apipoj/spark-stand-dual/assets/images/README.md

# Dual render images

Project-authored renders generated on 2026-10-17. The stand is Dual v04 with solid crossbars; the distributed print bundle instead includes v05 LIGHTER open crossbars, one with a logo. The images illustrate the overall arrangement rather than the exact released bar geometry.

Computer props are procedural visualization meshes created in this project, not official NVIDIA CAD. No imported device meshes, image textures, fonts or HDRIs are used. NVIDIA product identity and trademarks remain with their owners; no endorsement is implied. These images do not establish physical load or thermal performance.

Original render filenames are preserved. Restricted project terms in ../../LICENSE.md apply to the distributed images; no rights to underlying third-party trademarks or product designs are granted.

## Owner-supplied physical-build photographs

IMG_7394.jpg and IMG_7397.jpg show the printed Dual assembly photographed on 2026-10-11. The owner explicitly requested their public inclusion on 2026-10-20. These are the existing GitHub-sized JPEG copies, preserved byte-for-byte. Original HEIC files are not distributed. One photograph shows a single DGX Spark on the lower tier; neither photograph establishes two-device load or thermal performance.
