apipoj/spark-stand-dual/projects/X2D_PLA_v04_LIGHT_plate_04_pins_x8.3mf

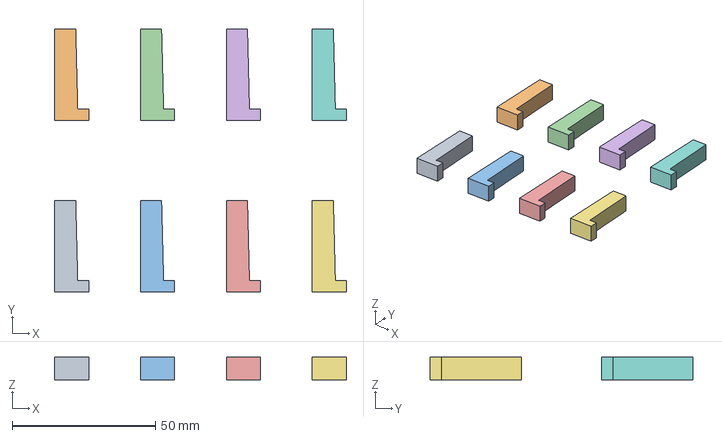
[picture p5: CAD file, 2026-10-20]
projects/X2D_PLA_v04_LIGHT_plate_04_pins_x8.3mf
102.0 x 92.0 x 8.00 mm
wedge_pin_PRINT_EIGHT x 8
