apipoj/spark-stand-dual/projects/X2D_PLA_v04_LIGHT_plate_01_right.3mf

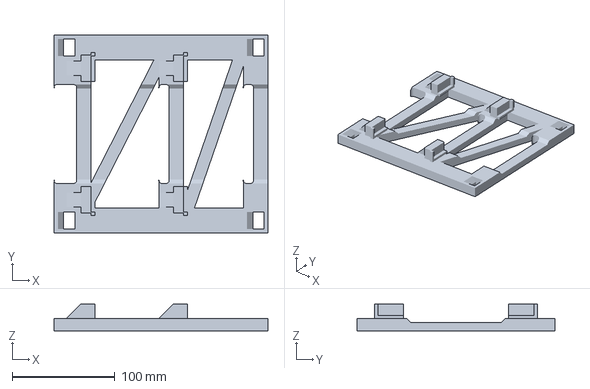
[picture p6: CAD file, 2026-10-20]
projects/X2D_PLA_v04_LIGHT_plate_01_right.3mf
208.0 x 192.0 x 26.0 mm
