apipoj/spark-stand-dual/projects/X2D_PLA_v05_LIGHTER_plate_03_crossbars_x4.3mf

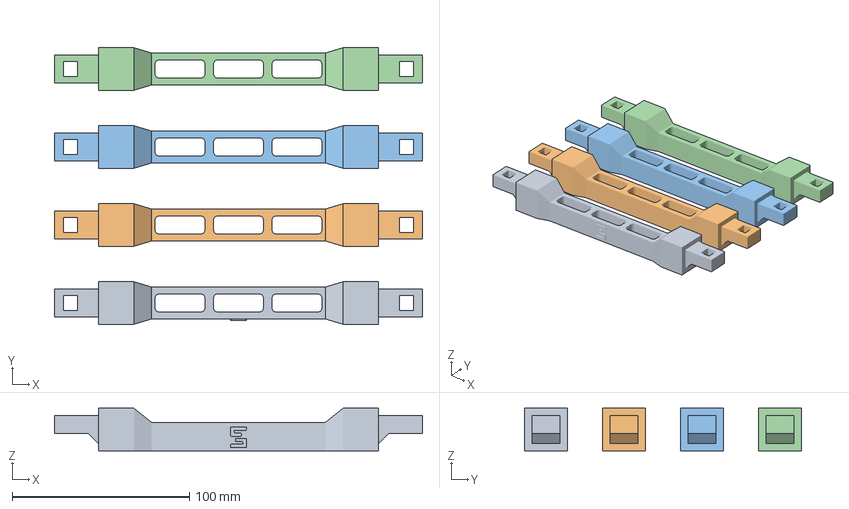
[picture p7: CAD file, 2026-10-20]
projects/X2D_PLA_v05_LIGHTER_plate_03_crossbars_x4.3mf
207.6 x 156.0 x 24.0 mm
crossbar_LOGO_PRINT_ONE
crossbar_plain x 3
