apipoj/spark-stand-dual/(list of files, cad)

Other CAD files:
projects/X2D_PLA_v04_LIGHT_plate_02_left.3mf
