apipoj/spark-stand-dual/ASSEMBLY_TH.md

# ประกอบ Spark Stand Dual

ชิ้นส่วนรวม 14 ชิ้น ได้แก่แผงซ้ายและขวา คานสี่ชิ้น และลิ่มแปดชิ้น

1. แกะ brim และ support ใต้เดือยออกให้หมด
2. ตั้งแผงสองข้างให้ชั้นรองหันเข้าใน เชื่อมด้วยคานหน้าและหลังทั้งด้านบนและด้านล่าง
3. สอดเดือยทะลุเบ้ารับจนบ่าคานแนบแผง หันด้านลาดให้ตรงกัน
4. ใส่ปลายแคบของลิ่มจากด้านบนช่องนอกแผง ด้านเรียบแนบแผง ด้านเอียงหันออก
5. กดด้วยมือให้กระชับ หัวลิ่มโผล่ได้ ไม่ตอกหรือฝืน
6. ใช้ลิ่มหนึ่งอันต่อข้อต่อ รวมแปดจุด ตรวจว่าไม่มีระยะคลอน ลิ่มไม่เลื่อนเองและปลายลิ่มไม่ยื่นต่ำกว่าฐาน

ใส่ยางรองจุดสัมผัสและใต้ฐานตามขนาดที่วัดจริง ทดลองด้วยน้ำหนักทดแทนก่อนใช้อุปกรณ์จริง หากชิ้นงานแตก แอ่น โยกหรือลิ่มคลาย ให้หยุดใช้งาน ผลความพอดีของข้อต่อไม่ยืนยันกำลังรับน้ำหนักหรือความทนความร้อนของโครงเต็ม
