apipoj/spark-stand-dual/(commit log)

2026-10-20 Publish Spark Stand Dual personal-use print bundle
    [X2D_PLA_v04_LIGHT_plate_01_right.3mf, X2D_PLA_v04_LIGHT_plate_02_left.3mf, X2D_PLA_v04_LIGHT_plate_04_pins_x8.3mf, X2D_PLA_v05_LIGHTER_plate_03_crossbars_x4.3mf]
2026-10-20 Link directly to prototype download release
2026-10-20 Add owner-approved photographs of printed Dual stand
